Teruru-52/Mercury-v2-pcb/(commit log)

2024-08-07 feat: improve pcb
    [Mercury-v2-pcb.kicad_pcb, Mercury-v2-pcb.kicad_sch, fan_driver.kicad_sch, imu.kicad_sch, ir_led.kicad_sch, ir_led_single.kicad_sch, ir_sensor.kicad_sch, mcu.kicad_sch]
2024-08-08 feat: route tracks
    [Mercury-v2-pcb.kicad_pcb, Mercury-v2-pcb.kicad_sch, ir_sensor.kicad_sch, mcu.kicad_sch]
2024-08-08 feat: add filled zone
    [Mercury-v2-pcb.kicad_pcb]
2024-08-08 feat: finish zone and via
    [Mercury-v2-pcb.kicad_pcb]
